intmodzero/Capstone-2015-rev0/rev0_demo/rev0.pdf

## The Magic Mouse

Revision 0 Demonstration

Michael Lawson Victor Tang

February 9, 2015

Michael Lawson, Victor Tang | The Magic Mouse | February 9, 2015 | 1 / 10

## Outline

1 | Project Description
2 | Proof of Concept Demonstration
3 | Progression from Proof of Concept
4 | Circuit Board Designs
5 | Looking Forward
6 | Demonstration
Michael Lawson, Victor Tang | The Magic Mouse | February 9, 2015 | 2 / 10

## Project Description

Temperature and electrical conductivity sensors integrated into a mouse shell with accelerometer
Collect temperature, accelerometer, and electrical conductivity data remotely in a database on a per user basis
Visualize data on a web interface – personal or administrator views Manage user accounts and data from administrator view
Michael Lawson, Victor Tang | The Magic Mouse | February 9, 2015 | 3 / 10

## Proof of Concept Demonstration

1 | Microcontroller development board
2 | Two temperature sensors
3 | Data streaming over UART (serial) to a text file
4 | Live data visualization by watching text file
5 | Static data visualization on webpage
Michael Lawson, Victor Tang | The Magic Mouse | February 9, 2015 | 4 / 10

## Progression from Proof of Concept

Microcontroller development board
I Circuit board design complete and boards ordered
I CAD word to be completed with known circuit board dimensions Two temperature sensors
I Two temperature sensors
I Two electrical conductivity values
I Accelerometer values (x,y,z)
Michael Lawson, Victor Tang | The Magic Mouse | February 9, 2015 | 5 / 10

## Progression from Proof of Concept Continued

Data streaming over UART (serial) to a text file I Data streams using Bluetooth
I Data logged in remote database
Live data visualization by watching text file
I No live data visualization
Static data visualization by watching text file
I Web interface retrieves information from database
I Data shown on web interface reflects latest data in database
Michael Lawson, Victor Tang | The Magic Mouse | February 9, 2015 | 6 / 10

## Sensor Board Design

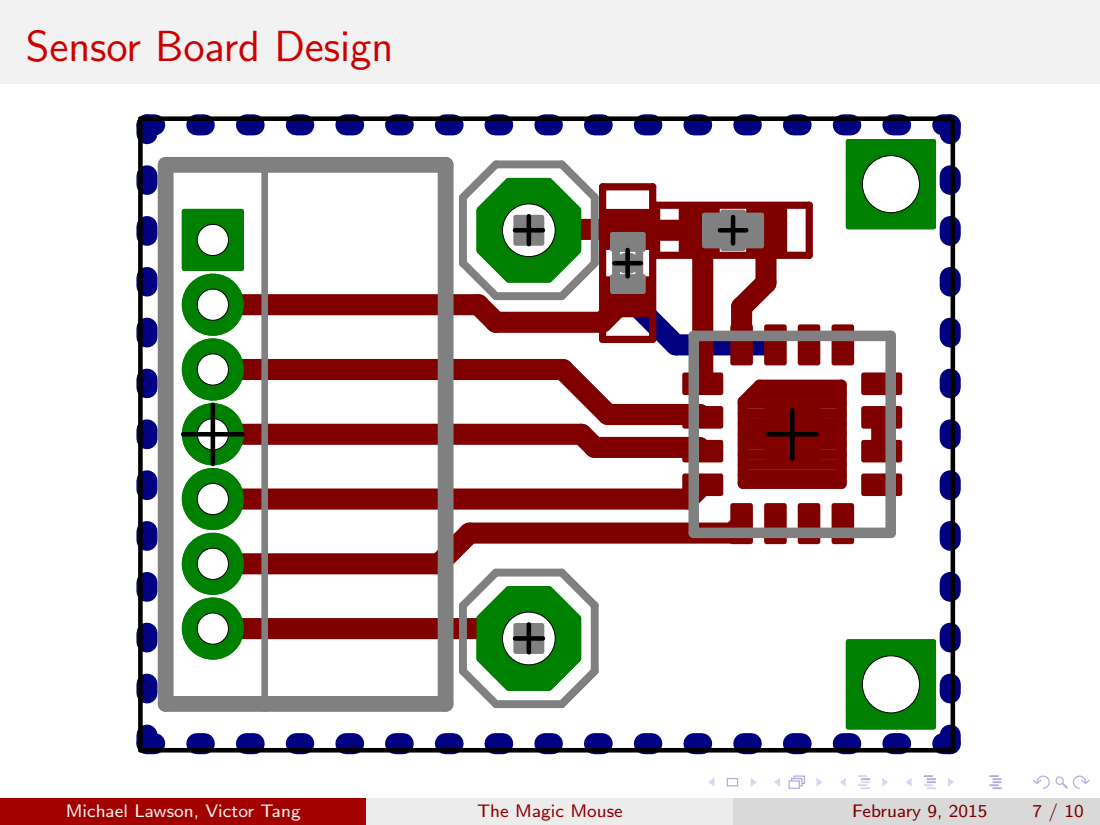
[picture p1: page 7]
Michael Lawson, Victor Tang; The Magic Mouse; February 9, 2015

## Main Board Design

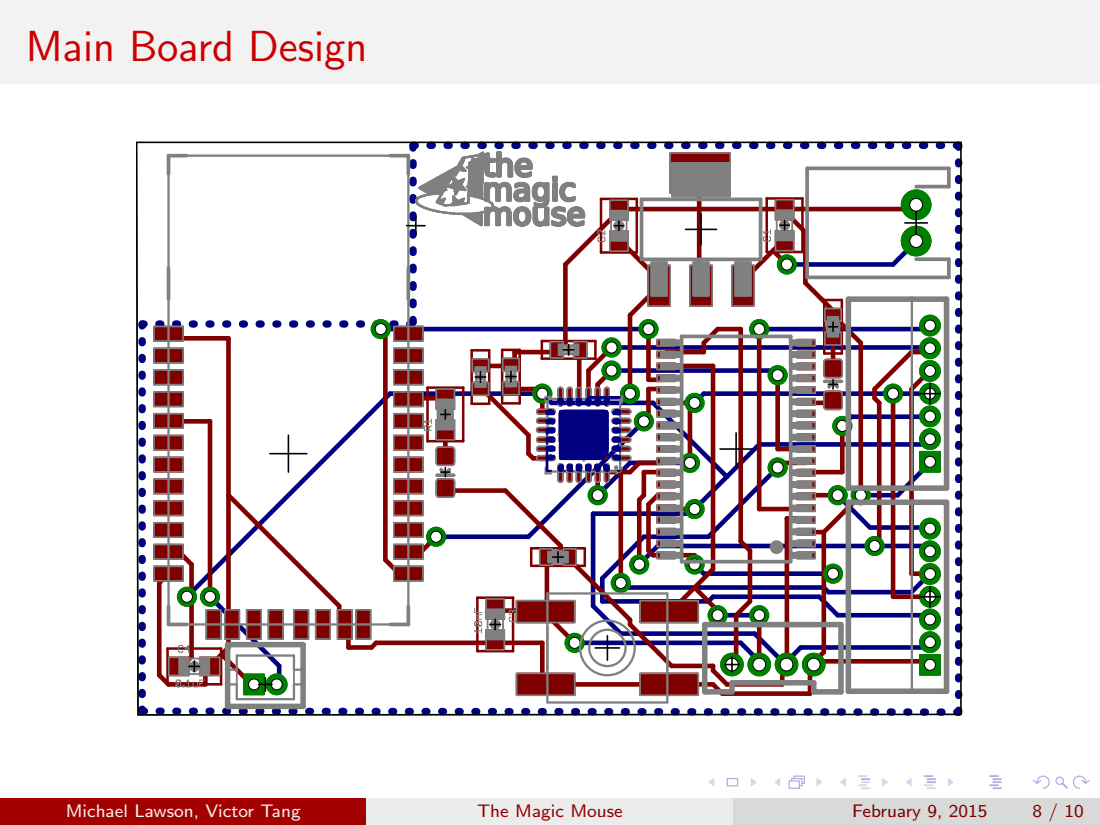
[picture p2: page 8]
Michael Lawson, Victor Tang; The Magic Mouse; February 9, 2015

## Looking Forward

Circuit boards to arrive in two weeks CAD for mouse body can be completed

Electrical conductivity integration
Data windowing
Beautification of the web interface
Data filtering for more meaningful display
Michael Lawson, Victor Tang | The Magic Mouse | February 9, 2015 | 9 / 10

## Demonstration

Magic Mouse Web Interface

Michael Lawson, Victor Tang | The Magic Mouse | February 9, 2015 | 10 / 10
