intmodzero/Capstone-2015-rev0/cad/mouse-base.stl

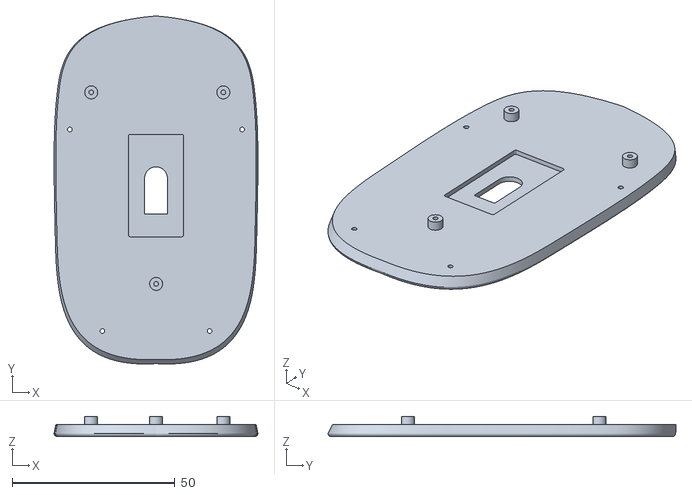
[picture p3: CAD file, 2018-04-19]
cad/mouse-base.stl
62.7 x 107.1 x 6.24
