intmodzero/Capstone-2015-rev0/cad/mouse.fcstd

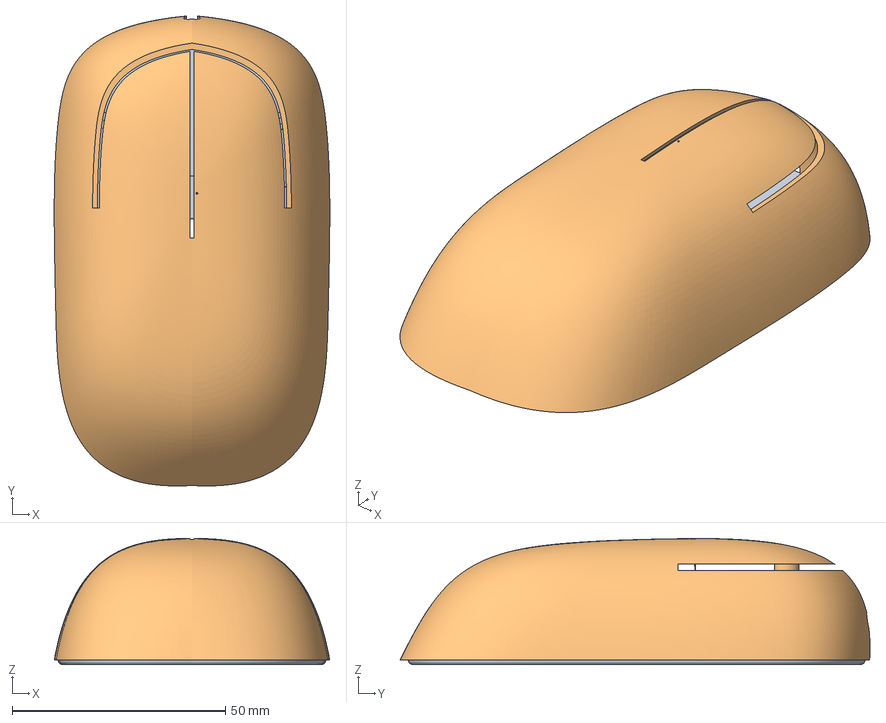
[picture p4: CAD file, 2018-04-19]
cad/mouse.fcstd
64.6 x 110.1 x 29.5 mm
mouse-base
mouse-shell
