intmodzero/Capstone-2015-rev0/cad/mouse-shell.stl

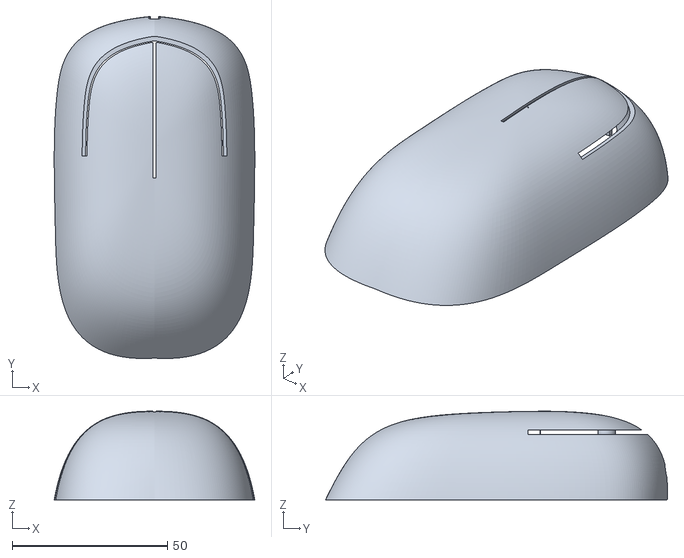
[picture p5: CAD file, 2018-04-19]
cad/mouse-shell.stl
64.6 x 110.1 x 28.5
