intmodzero/Capstone-2015-rev0/eagle/temp.brd

## EAGLE design eagle/temp.brd (2018-04-19)

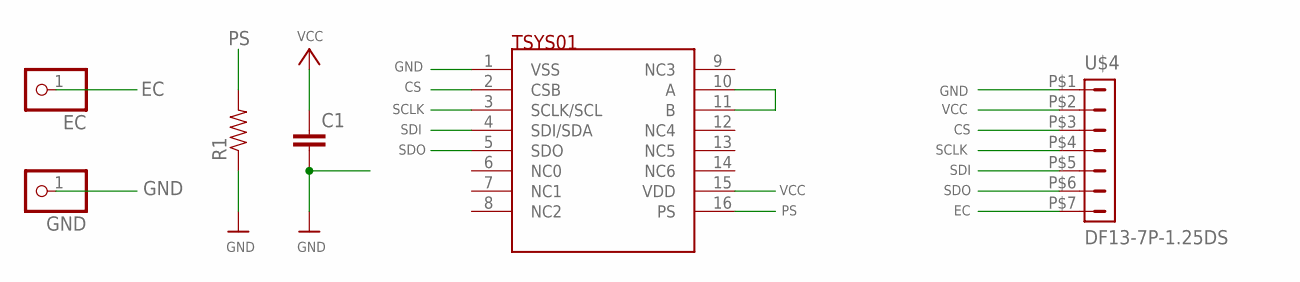
[picture p6: schematic temp.sch]

Parts:
C1: CAP0402-CAP; 0402-CAP
EC: PINHD-1X1; 1X01
GND: PINHD-1X1; 1X01
R1: RESISTOR0402-RES; 0402-RES
U$1: TSYS01; QFN16
U$4: DF13-7P-1.25DS

Connections:
CS: U$1.2 (CSB), U$4.P$3 (3)
EC: EC.1, U$4.P$7 (7)
GND: C1.2, GND.1, R1.1, U$1.1 (VSS), U$4.P$1 (1)
unnamed: U$1.10 (A), U$1.11 (B)
PS: R1.2, U$1.16 (PS)
SCLK: U$1.3 (SCLK/SCL), U$4.P$4 (4)
SDI: U$1.4 (SDI/SDA), U$4.P$5 (5)
SDO: U$1.5 (SDO), U$4.P$6 (6)
VCC: C1.1, U$1.15 (VDD), U$4.P$2 (2)

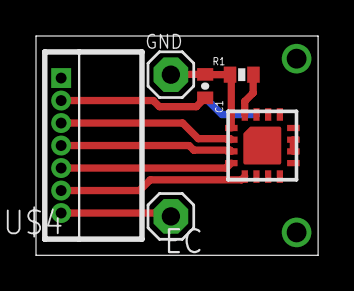
[picture p7: board temp.brd from above]

Board: 2 copper layers, 15.7 x 12.2 mm, 6 parts (0 on the bottom side), 9 nets.
