intmodzero/Capstone-2015-rev0/eagle/main_board.brd

## EAGLE design eagle/main_board.brd (2018-04-19)

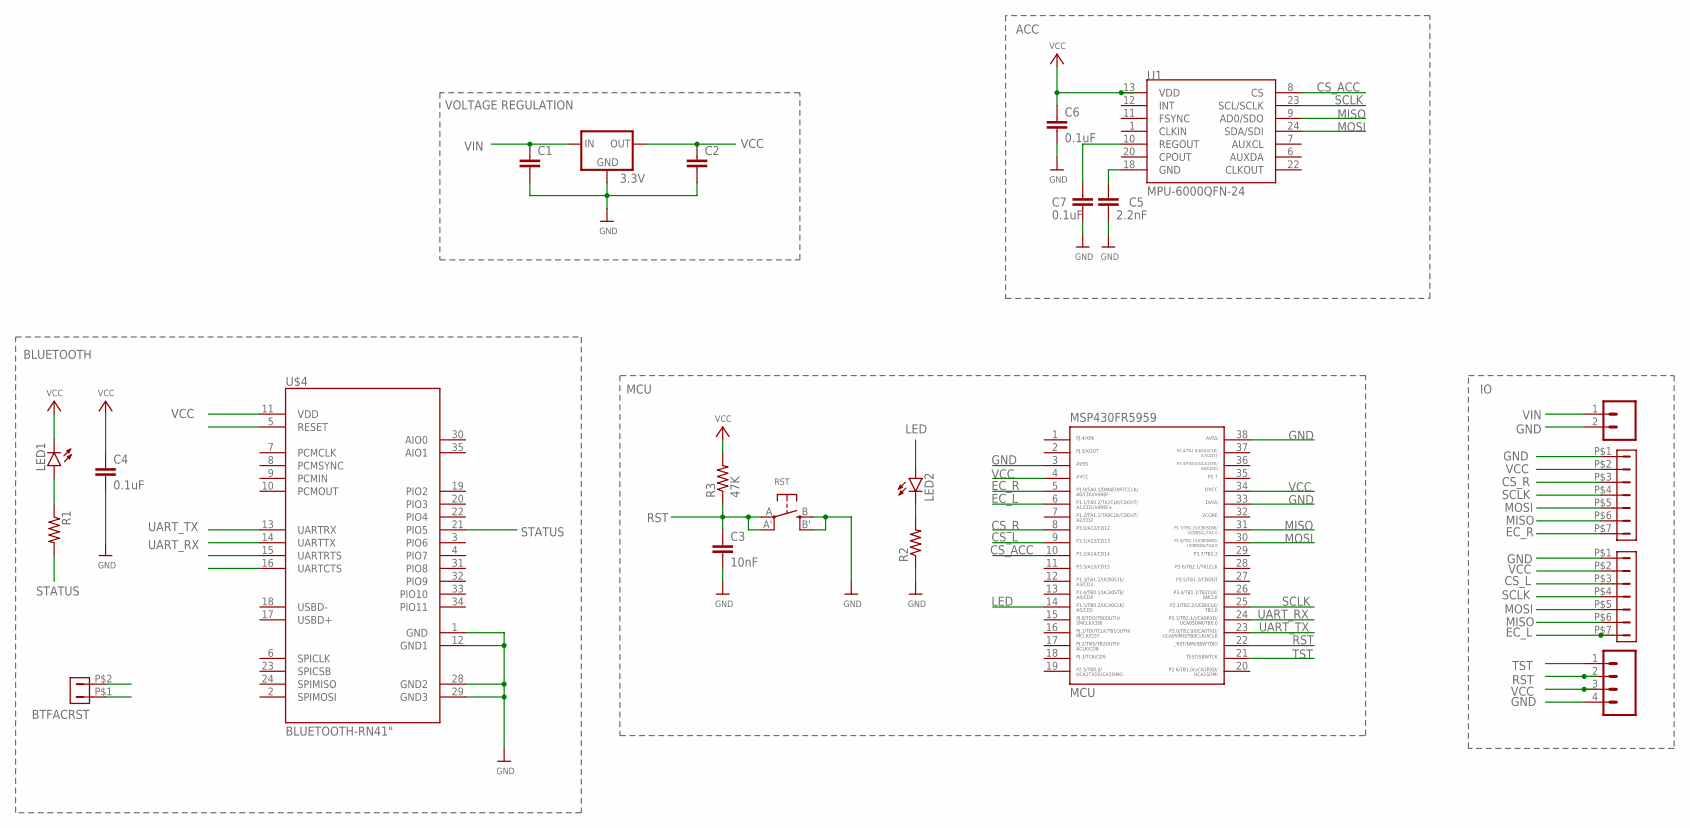
[picture p8: schematic main_board.sch]

Parts:
3.3V: V_REG_78XX; SOT223
5V: M02-JST-2-PTH-NO_SILK; JST-2-PTH-NS
BTFACRST: DF13-2P-1.25DSA
C1, C2: CAP0603-CAP; 0603-CAP
C3: 10nF; 0603-CAP
C4: 0.1uF; 0603-CAP
C5: 2.2nF; 0402-CAP
C6, C7: 0.1uF; 0402-CAP
LED1, LED2: LED0603; LED-0603
LEFT: DF13-7P-1.25DS
MCU: MSP430FR5959; TSSOP38_R-PDSO-G38-DA
PGM: M04JST; 1X04-1.5MM_JST
R1: RESISTOR0603-RES; 0603-RES
R2: RESISTOR0402-RES; 0402-RES
R3: 47K; 0402-RES
RIGHT: fname; DF13-7P-1.25DS
RST: SWITCH_TACT_SMT; EVQ-Q2
U1: MPU-6000QFN-24; QFN-24-TESTING
U$4: BLUETOOTH-RN41"; RN41

Connections:
BTRST: BTFACRST.P$2 (2), U$4.5 (RESET)
CS_ACC: MCU.10, U1.8 (CS)
CS_L: LEFT.P$3 (3), MCU.9
CS_R: MCU.8, RIGHT.P$3 (3)
EC_L: LEFT.P$7 (7), MCU.6
EC_R: MCU.5, RIGHT.P$7 (7)
GND: 3.3V.2 (GND), 3.3V.4 (GND), 5V.2, BTFACRST.P$1 (1), C1.2, C2.2, C3.2, C4.2, C5.2, C6.2, C7.2, LEFT.P$1 (1), MCU.3, MCU.33, MCU.38, PGM.4, R2.1, RIGHT.P$1 (1), RST.B (S), RST.B' (S1), U$4.1 (GND), U$4.12 (GND1), U$4.28 (GND2), U$4.29 (GND3)
LED: LED2.A, MCU.14
MISO: LEFT.P$6 (6), MCU.31, RIGHT.P$6 (6), U1.9 (AD0/SDO)
MOSI: LEFT.P$5 (5), MCU.30, RIGHT.P$5 (5), U1.24 (SDA/SDI)
unnamed: LED2.C, R2.2
unnamed: C7.1, U1.10 (REGOUT)
unnamed: C5.1, U1.18 (GND)
unnamed: LED1.A, R1.1
RST: C3.1, MCU.22, PGM.2, R3.1, RST.A, RST.A' (P1)
SCLK: LEFT.P$4 (4), MCU.25, RIGHT.P$4 (4), U1.23 (SCL/SCLK)
STATUS: R1.2, U$4.21 (PIO5)
TST: MCU.21, PGM.1
UART_RX: MCU.24, U$4.14 (UARTTX)
UART_TX: MCU.23, U$4.13 (UARTRX)
VCC: 3.3V.1 (OUT), C2.1, C4.1, C6.1, LED1.C, LEFT.P$2 (2), MCU.4, MCU.34, PGM.3, R3.2, RIGHT.P$2 (2), U1.13 (VDD), U$4.11 (VDD)
VIN: 3.3V.3 (IN), 5V.1, C1.1

Notes on the sheet:
MCU
BLUETOOTH
VOLTAGE REGULATION
ACC

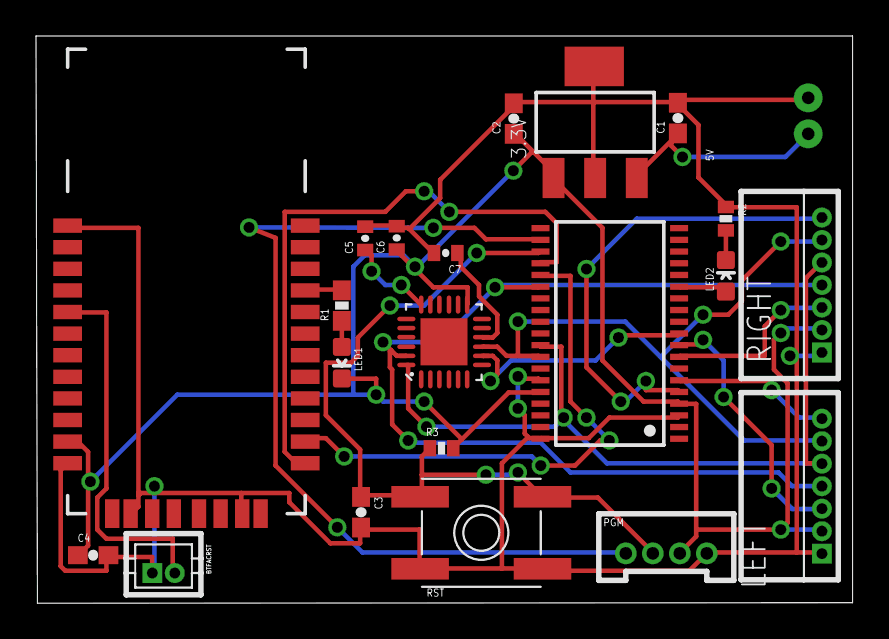
[picture p9: board main_board.brd from above]

Board: 2 copper layers, 45.4 x 31.5 mm, 23 parts (0 on the bottom side), 22 nets.

Other parts of the board:
U$1: MMLOGO
