intmodzero/Capstone-2015-rev0/driver/magic_driver.py

#!/usr/bin/env python2
"""
magic_driver.py

The Magic Mouse
McMaster University
Computer Science Capstone
2014/2015

Michael Lawson
Victor Tang
"""

class MousePacket(object):
    def __init__(self,packet_tuple):
        pass
    def parse_packet(self):
        pass

class MagicMouse(object):
    def __init__(self,device)
        self.device = device
