intmodzero/Capstone-2015-rev0/firmware/spi.h

#pragma once

void spi_UCA1_init(unsigned int clocksettings, unsigned char);

unsigned char spi_UCA1_send_receive(unsigned char send);

void spi_UCB0_init(unsigned int clocksettings);

unsigned char spi_UCB0_send_receive(unsigned char send);
